adeshni0308-hub/ALU-Forge/8BIT_ALU_.jpeg

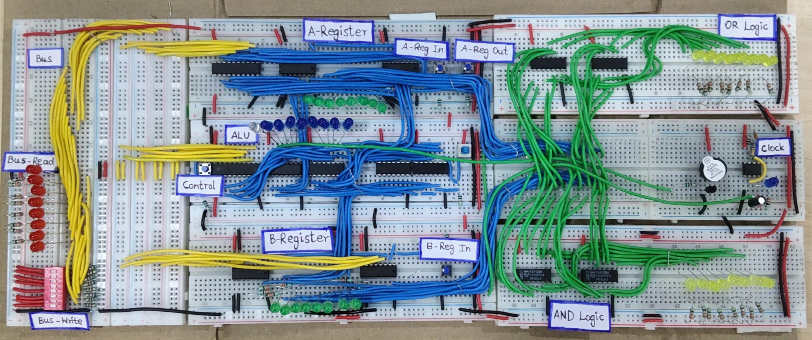
8BIT_ALU_.jpeg
