adeshni0308-hub/ALU-Forge/8- bit ALU Schematic.pdf

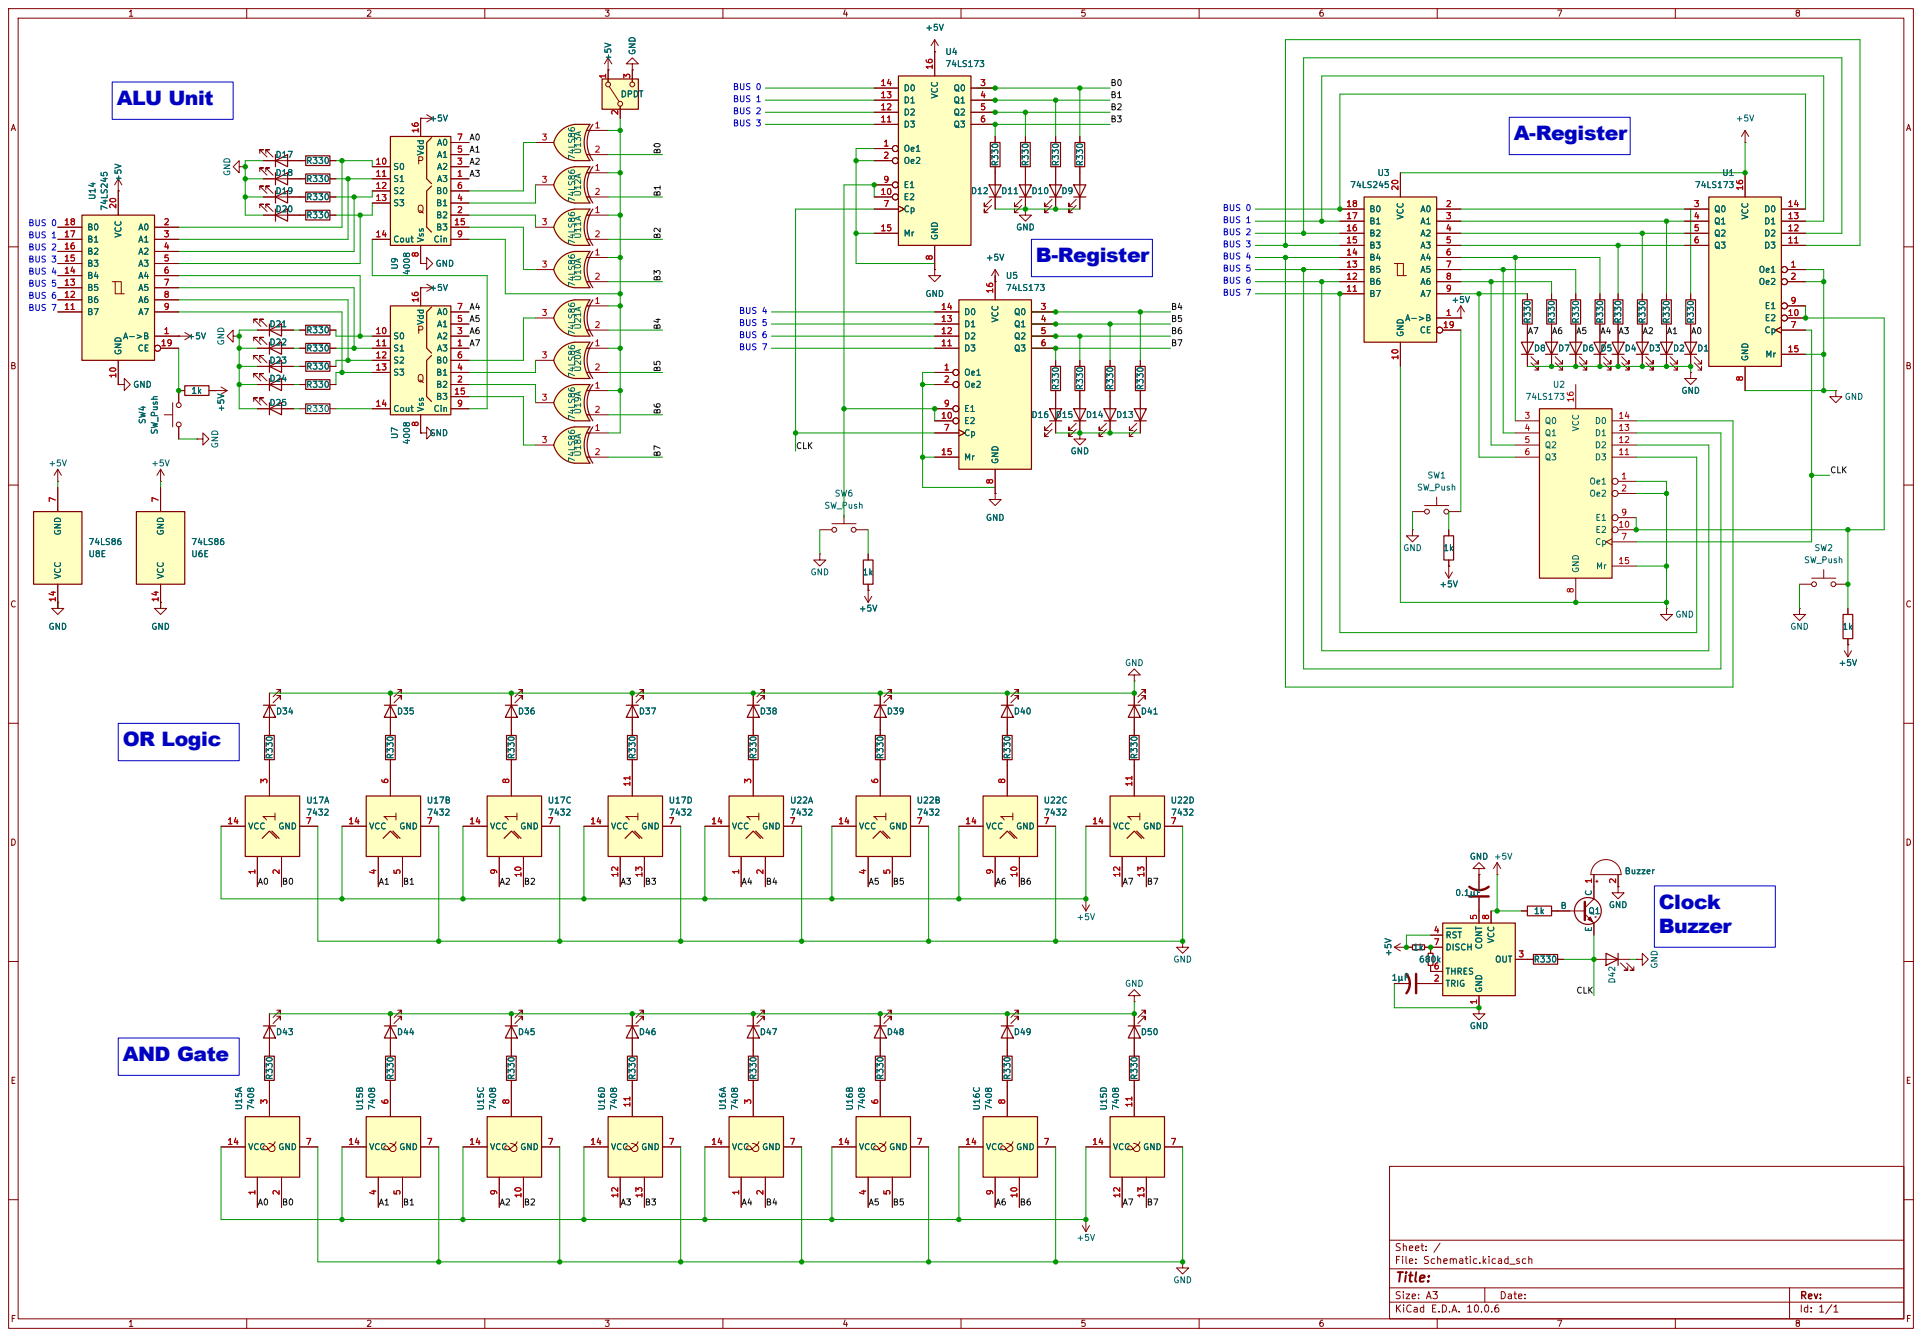
[picture p11: page 1]

Size: A3 | Rev: | F Date:
KiCad E.D.A. 10.0.6 | Id: 1/1
