adeshni0308-hub/ALU-Forge/Schematic.kicad_sch

## KiCad design Schematic.kicad_sch (2026-09-26, last stored version)

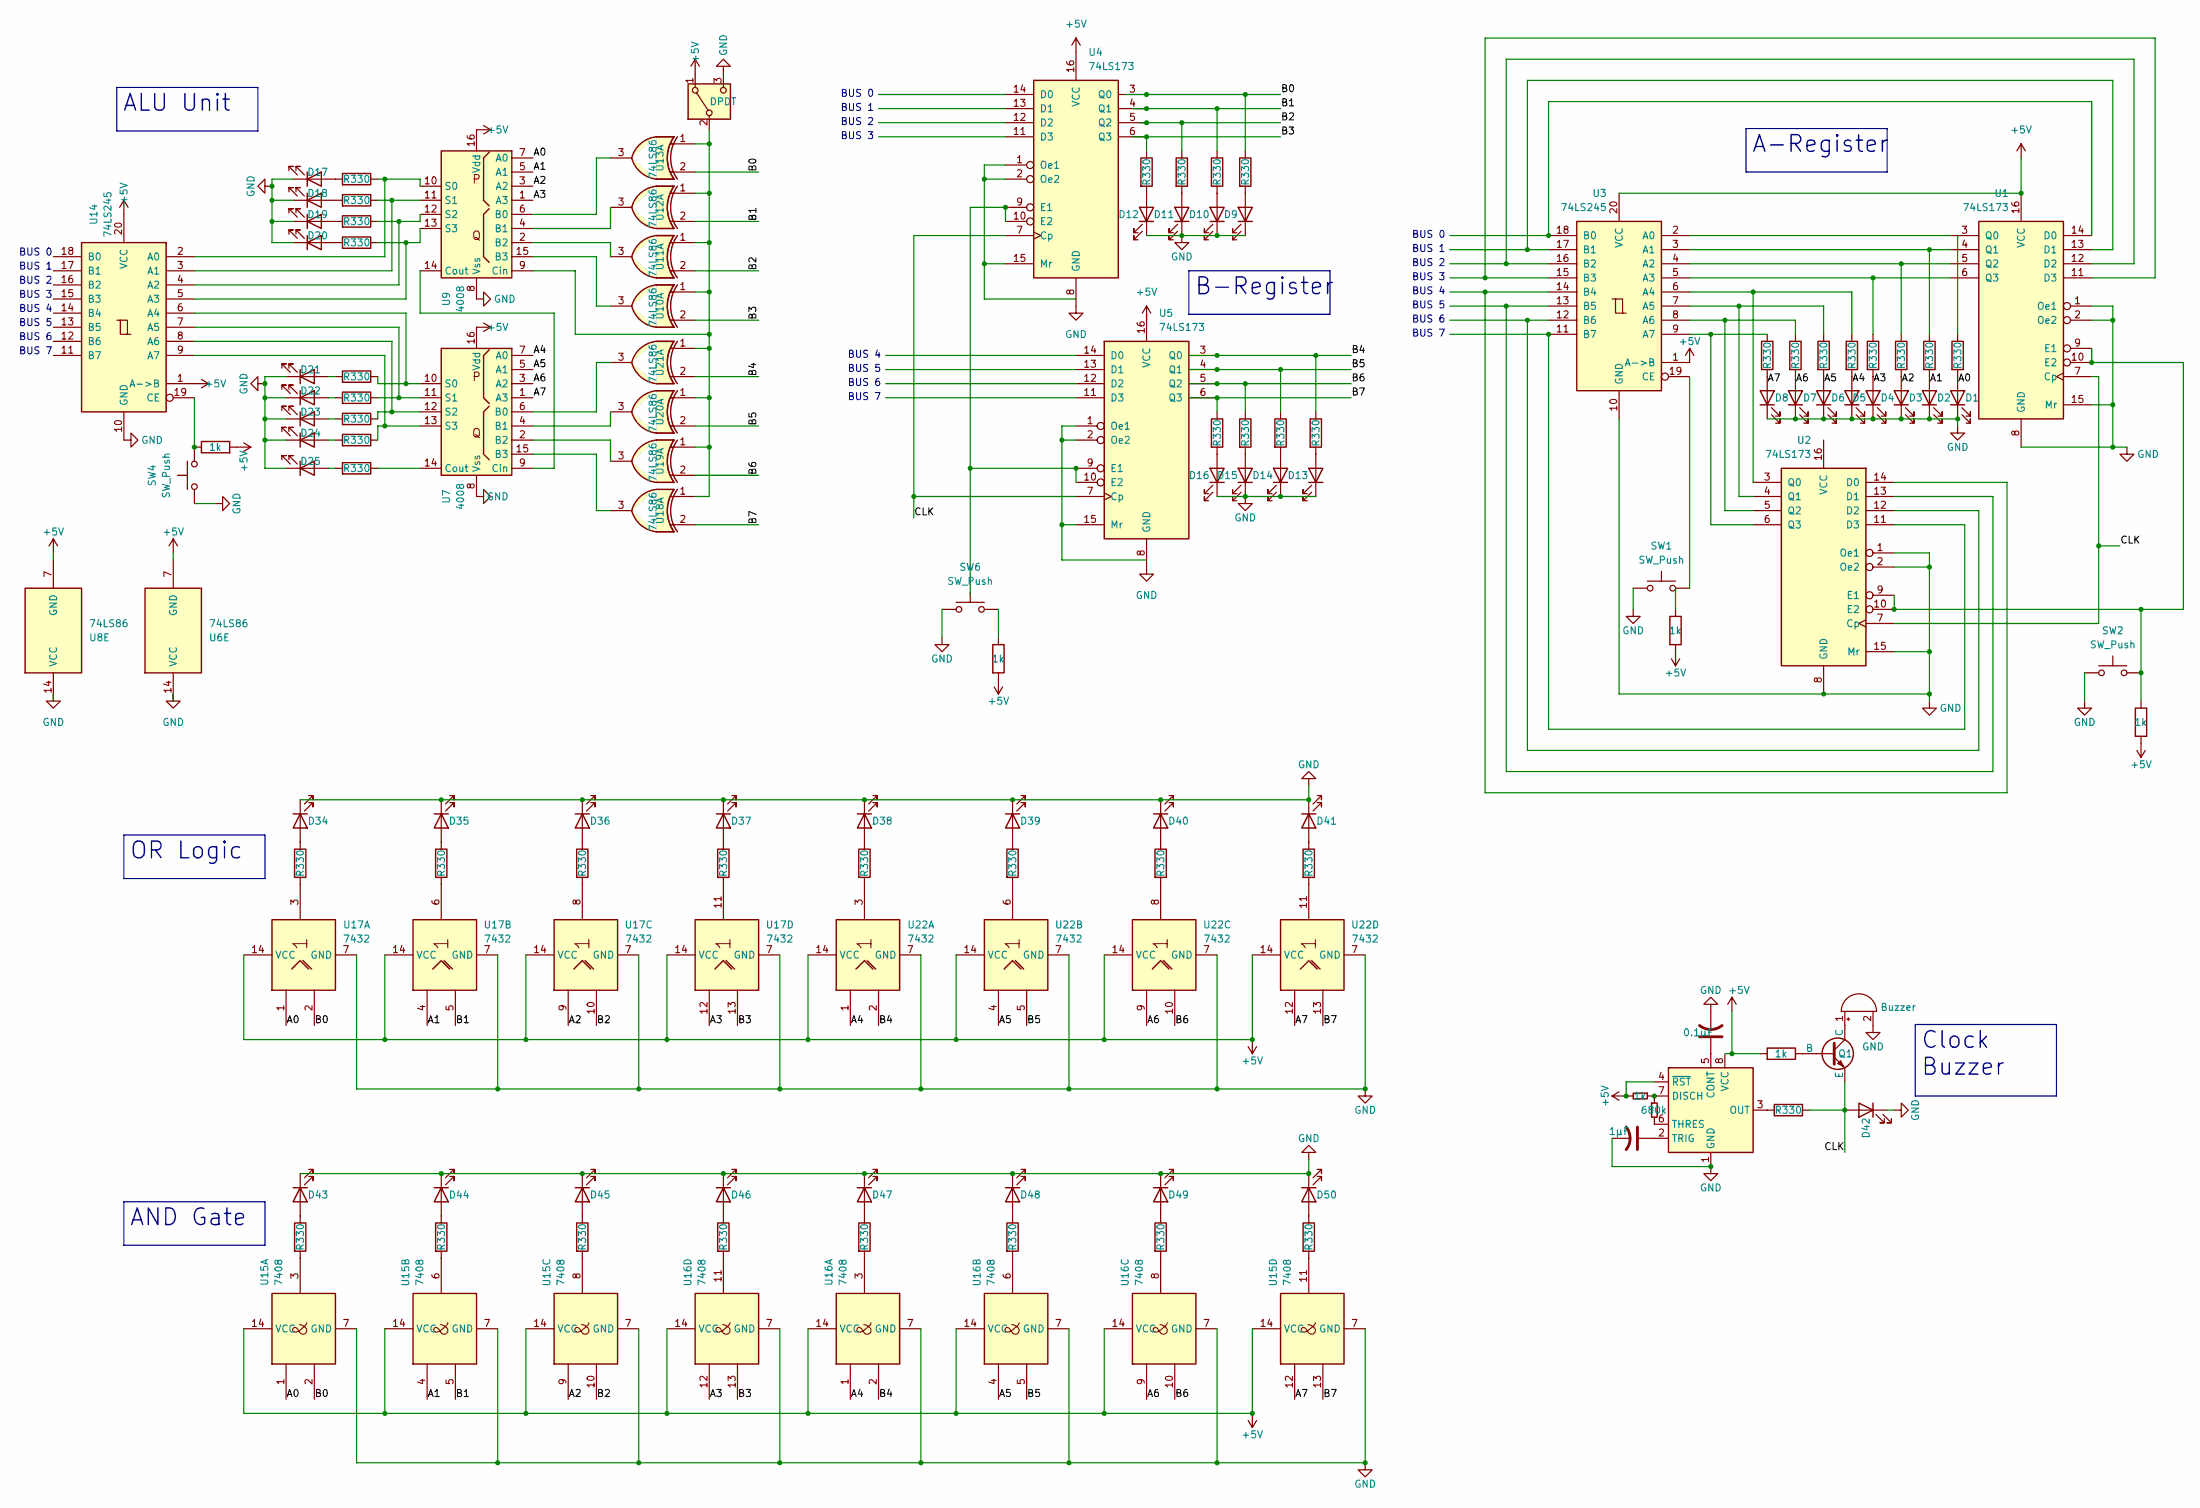
[picture p12: schematic Schematic.kicad_sch]

Parts:
0.1µF: C_US; SOIC-8_3.9x4.9mm_P1.27mm
1k: (no value)
1µF: C_US
680k: R
BZ1: Buzzer; TQFN-16-1EP_3x3mm_P0.5mm_EP1.6x1.6mm
D1, D2, D3, D4, D5, D6, D7, D8, D9, D10, D11, D12, D13, D14, D15, D16, D17, D18, D19, D20, D21, D22, D23, D24, D25, D34, D35, D36, D37, D38, D39, D40, D41, D42, D43, D44, D45, D46, D47, D48, D49, D50: (no value)
Q1: NPN; Nordic_AQFN-94-1EP_7x7mm_P0.4mm
R330: (no value)
SW1, SW4: SW_Push; DIP-24_W7.62mm
SW2, SW6: SW_Push
SW5: DPDT
U1, U2, U4, U5: 74LS173
U3, U14: 74LS245; Xilinx_CSG48_7.0x7.0mm_Layout7x7_P0.8mm
U6, U8, U10, U11, U12, U13, U18, U19, U20, U21: 74LS86; Xilinx_CSG48_7.0x7.0mm_Layout7x7_P0.8mm
U7: 4008; DIP-40_W15.24mm
U9: 4008
U15: 7408; Filter_Mini-Circuits_FV1206
U16: 7408
U17: 7432; Xilinx_CSG48_7.0x7.0mm_Layout7x7_P0.8mm
U22: 7432
U23: ICM7555xB; SOIC-8_3.9x4.9mm_P1.27mm

Connections:
+5V: 1k.2, SW5.1 (A), U1.16 (VCC), U3.1 (A->B), U3.20 (VCC), U4.16 (VCC), U6.7 (GND), U7.16 (Vdd), U8.7 (GND), U9.16 (Vdd), U14.1 (A->B), U14.20 (VCC), U15.14 (VCC), U16.14 (VCC), U17.14 (VCC), U22.14 (VCC), U23.4 (~RST), U23.8 (VCC)
A0: U9.7 (A0), U15.1, U17.1
A1: U9.5 (A1), U15.4, U17.4
A2: U9.3 (A2), U15.9, U17.9
A3: U9.1 (A3), U16.12, U17.12
A4: U7.7 (A0), U16.1, U22.1
A5: U7.5 (A1), U16.4, U22.4
A6: U7.3 (A2), U16.9, U22.9
A7: U7.1 (A3), U15.12, U22.12
B0: R330.1, U4.3 (Q0), U13.2, U15.2, U17.2
B1: R330.1, U4.4 (Q1), U12.2, U15.5, U17.5
B2: R330.1, U4.5 (Q2), U11.2, U15.10, U17.10
B3: R330.1, U4.6 (Q3), U10.2, U16.13, U17.13
B4: R330.1, U5.3 (Q0), U16.2, U21.2, U22.2
B5: R330.1, U5.4 (Q1), U16.5, U20.2, U22.5
B6: R330.1, U5.5 (Q2), U16.10, U19.2, U22.10
B7: R330.1, U5.6 (Q3), U15.13, U18.2, U22.13
CLK: D42.2 (A), Q1.3 (E), R330.2, U1.7 (Cp), U2.7 (Cp), U4.7 (Cp), U5.7 (Cp)
GND: 0.1µF.2, 1µF.2, BZ1.2 (-), D1.1 (K), D2.1 (K), D3.1 (K), D4.1 (K), D5.1 (K), D6.1 (K), D7.1 (K), D8.1 (K), D9.1 (K), D10.1 (K), D11.1 (K), D12.1 (K), D13.1 (K), D14.1 (K), D15.1 (K), D16.1 (K), D17.1 (K), D18.1 (K), D19.1 (K), D20.1 (K), D21.1 (K), D22.1 (K), D23.1 (K), D24.1 (K), D25.1 (K), D34.1 (K), D35.1 (K), D36.1 (K), D37.1 (K), D38.1 (K), D39.1 (K), D40.1 (K), D41.1 (K), D42.1 (K), D43.1 (K), D44.1 (K), D45.1 (K), D46.1 (K), D47.1 (K), D48.1 (K), D49.1 (K), D50.1 (K), SW1.1, SW2.1, SW4.1, SW5.3 (C), SW6.1, U1.1 (Oe1), U1.2 (Oe2), U1.8 (GND), U1.15 (Mr), U2.1 (Oe1), U2.2 (Oe2), U2.8 (GND), U2.15 (Mr), U3.10 (GND), U4.8 (GND), U5.8 (GND), U6.14 (VCC), U7.8 (Vss), U8.14 (VCC), U9.8 (Vss), U14.10 (GND), U15.7 (GND), U16.7 (GND), U17.7 (GND), U22.7 (GND), U23.1 (GND)
unnamed: 0.1µF.1, U23.5 (CONT)
unnamed: 1k.1, 680k.1, Q1.2 (B), SW2.2, SW4.2, SW6.2, U1.9 (E1), U1.10 (E2), U2.9 (E1), U2.10 (E2), U14.19 (CE), U23.7 (DISCH)
unnamed: 1µF.1, U23.2 (TRIG)
unnamed: 680k.2, U23.6 (THRES)
unnamed: BZ1.1 (+), Q1.1 (C)
unnamed: D1.2 (A), R330.2
unnamed: D2.2 (A), R330.2
unnamed: D3.2 (A), R330.2
unnamed: D4.2 (A), R330.2
unnamed: D5.2 (A), R330.2
unnamed: D6.2 (A), R330.2
unnamed: D7.2 (A), R330.2
unnamed: D8.2 (A), R330.2
unnamed: D9.2 (A), R330.2
unnamed: D10.2 (A), R330.2
unnamed: D11.2 (A), R330.2
unnamed: D12.2 (A), R330.2
unnamed: D13.2 (A), R330.2
unnamed: D14.2 (A), R330.2
unnamed: D15.2 (A), R330.2
unnamed: D16.2 (A), R330.2
unnamed: D17.2 (A), R330.2
unnamed: D18.2 (A), R330.2
unnamed: D19.2 (A), R330.2
unnamed: D20.2 (A), R330.2
unnamed: D21.2 (A), R330.2
unnamed: D22.2 (A), R330.2
unnamed: D23.2 (A), R330.2
unnamed: D24.2 (A), R330.2
unnamed: D25.2 (A), R330.2
unnamed: D34.2 (A), R330.1
unnamed: D35.2 (A), R330.1
unnamed: D36.2 (A), R330.1
unnamed: D37.2 (A), R330.1
unnamed: D38.2 (A), R330.1
unnamed: D39.2 (A), R330.1
unnamed: D40.2 (A), R330.1
unnamed: D41.2 (A), R330.1
unnamed: D43.2 (A), R330.1
unnamed: D44.2 (A), R330.1
unnamed: D45.2 (A), R330.1
unnamed: D46.2 (A), R330.1
unnamed: D47.2 (A), R330.1
unnamed: D48.2 (A), R330.1
unnamed: D49.2 (A), R330.1
unnamed: D50.2 (A), R330.1
unnamed: R330.1, U1.4 (Q1), U1.5 (Q2), U1.6 (Q3), U2.3 (Q0), U2.4 (Q1), U2.5 (Q2), U2.6 (Q3), U3.3 (A1), U3.4 (A2), U3.5 (A3), U3.6 (A4), U3.7 (A5), U3.8 (A6), U3.9 (A7), U7.10 (S0), U7.11 (S1), U7.12 (S2), U7.13 (S3), U7.14 (Cout), U9.10 (S0), U9.11 (S1), U9.12 (S2), U9.13 (S3), U14.2 (A0), U14.3 (A1), U14.4 (A2), U14.5 (A3), U14.6 (A4), U14.7 (A5), U14.8 (A6), U14.9 (A7), U23.3 (OUT)
unnamed: R330.2, U15.3, U15.6, U15.8, U15.11, U16.3, U16.6, U16.8, U16.11, U17.3, U17.6, U17.8, U17.11, U22.3, U22.6, U22.8, U22.11
unnamed: SW1.2, U3.19 (CE)
unnamed: SW5.2 (B), U9.9 (Cin), U10.1, U11.1, U12.1, U13.1, U18.1, U19.1, U20.1, U21.1
unnamed: U1.3 (Q0), U3.2 (A0)
unnamed: U1.11 (D3), U3.15 (B3)
unnamed: U1.12 (D2), U3.16 (B2)
unnamed: U1.13 (D1), U3.17 (B1)
unnamed: U1.14 (D0), U3.18 (B0)
unnamed: U2.11 (D3), U3.11 (B7)
unnamed: U2.12 (D2), U3.12 (B6)
unnamed: U2.13 (D1), U3.13 (B5)
unnamed: U2.14 (D0), U3.14 (B4)
unnamed: U4.1 (Oe1), U4.2 (Oe2), U4.15 (Mr)
unnamed: U4.9 (E1), U4.10 (E2), U5.9 (E1), U5.10 (E2)
unnamed: U5.1 (Oe1), U5.2 (Oe2), U5.15 (Mr)
unnamed: U7.9 (Cin), U9.14 (Cout)
unnamed: U9.15 (B3), U10.3
unnamed: U9.2 (B2), U11.3
unnamed: U9.4 (B1), U12.3
unnamed: U9.6 (B0), U13.3
unnamed: U7.15 (B3), U18.3
unnamed: U7.2 (B2), U19.3
unnamed: U7.4 (B1), U20.3
unnamed: U7.6 (B0), U21.3

Notes on the sheet:
BUS 7
BUS 6
BUS 2
BUS 0
BUS 1
BUS 3
BUS 4
BUS 5
Clock Buzzer
A-Register
B-Register
OR Logic
AND Gate
ALU Unit
