adeshni0308-hub/ALU-Forge/(commit log)

2026-09-23 Addes file Schematic.kicad_.lck , ALU-Forg26 and Bit-Mechanix - ALU-Forge26
    [Schematic.kicad_sch]
2026-09-26 Added Schematic PDF
    [Schematic.kicad_sch]
2026-09-26 Added Schematic for 8-bit ALU in PDF format
    [Schematic.kicad_sch]
